Connor-Vickers/SASSII-PSP/PCB/untitled.BOT.bmp

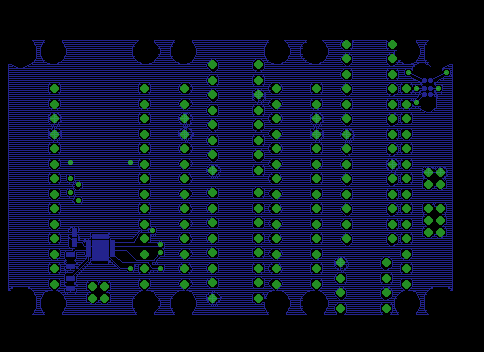
PCB/untitled.BOT.bmp
