Connor-Vickers/SASSII-PSP/PCB/untitled.DD1.bmp

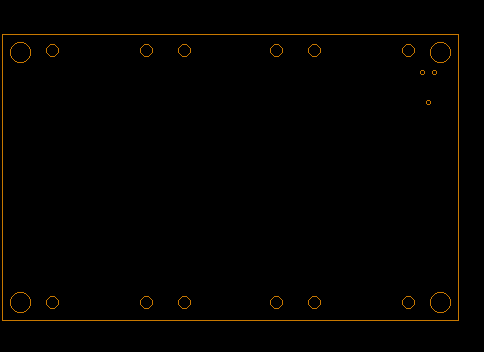
PCB/untitled.DD1.bmp
