Connor-Vickers/SASSII-PSP/PCB/untitled.GTO.bmp

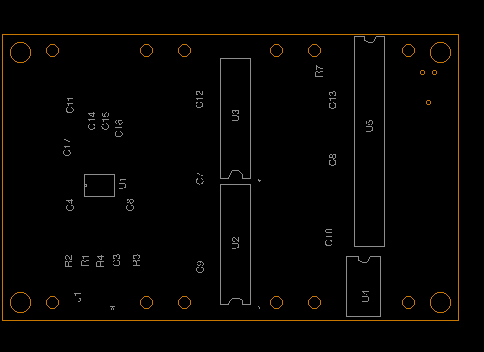
PCB/untitled.GTO.bmp
