Connor-Vickers/SASSII-PSP/PCB/untitled.L2.bmp

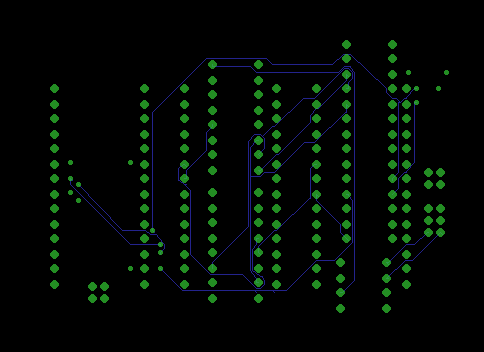
PCB/untitled.L2.bmp
