Connor-Vickers/SASSII-PSP/PCB/untitled.MSK.bmp

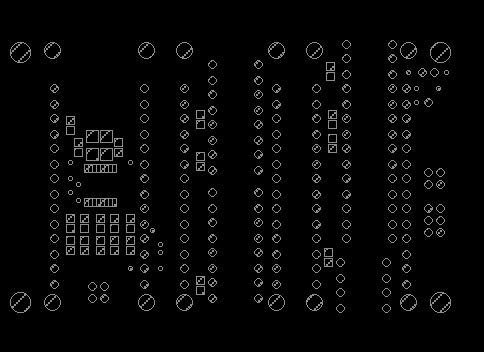
PCB/untitled.MSK.bmp
