Connor-Vickers/SASSII-PSP/PCB/untitled.STS.bmp

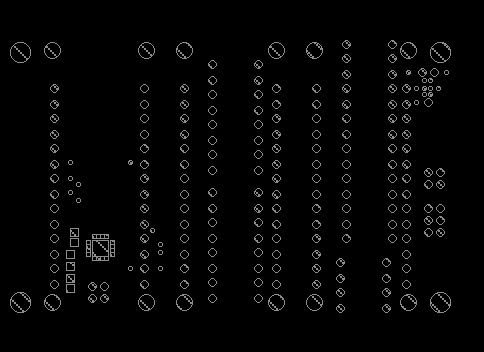
PCB/untitled.STS.bmp
