Connor-Vickers/SASSII-PSP/PCB/untitled.TAP.bmp

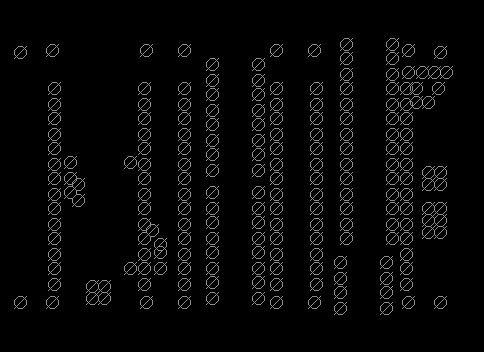
PCB/untitled.TAP.bmp
