Connor-Vickers/SASSII-PSP/PCB/untitled.TOP.bmp

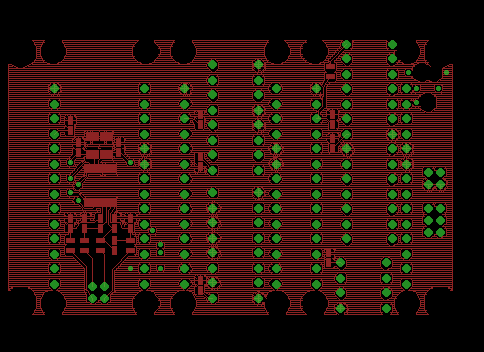
PCB/untitled.TOP.bmp
