Connor-Vickers/SASSII-PSP/PCB/untitled.brd

## EAGLE design PCB/untitled.brd (2017-12-06)

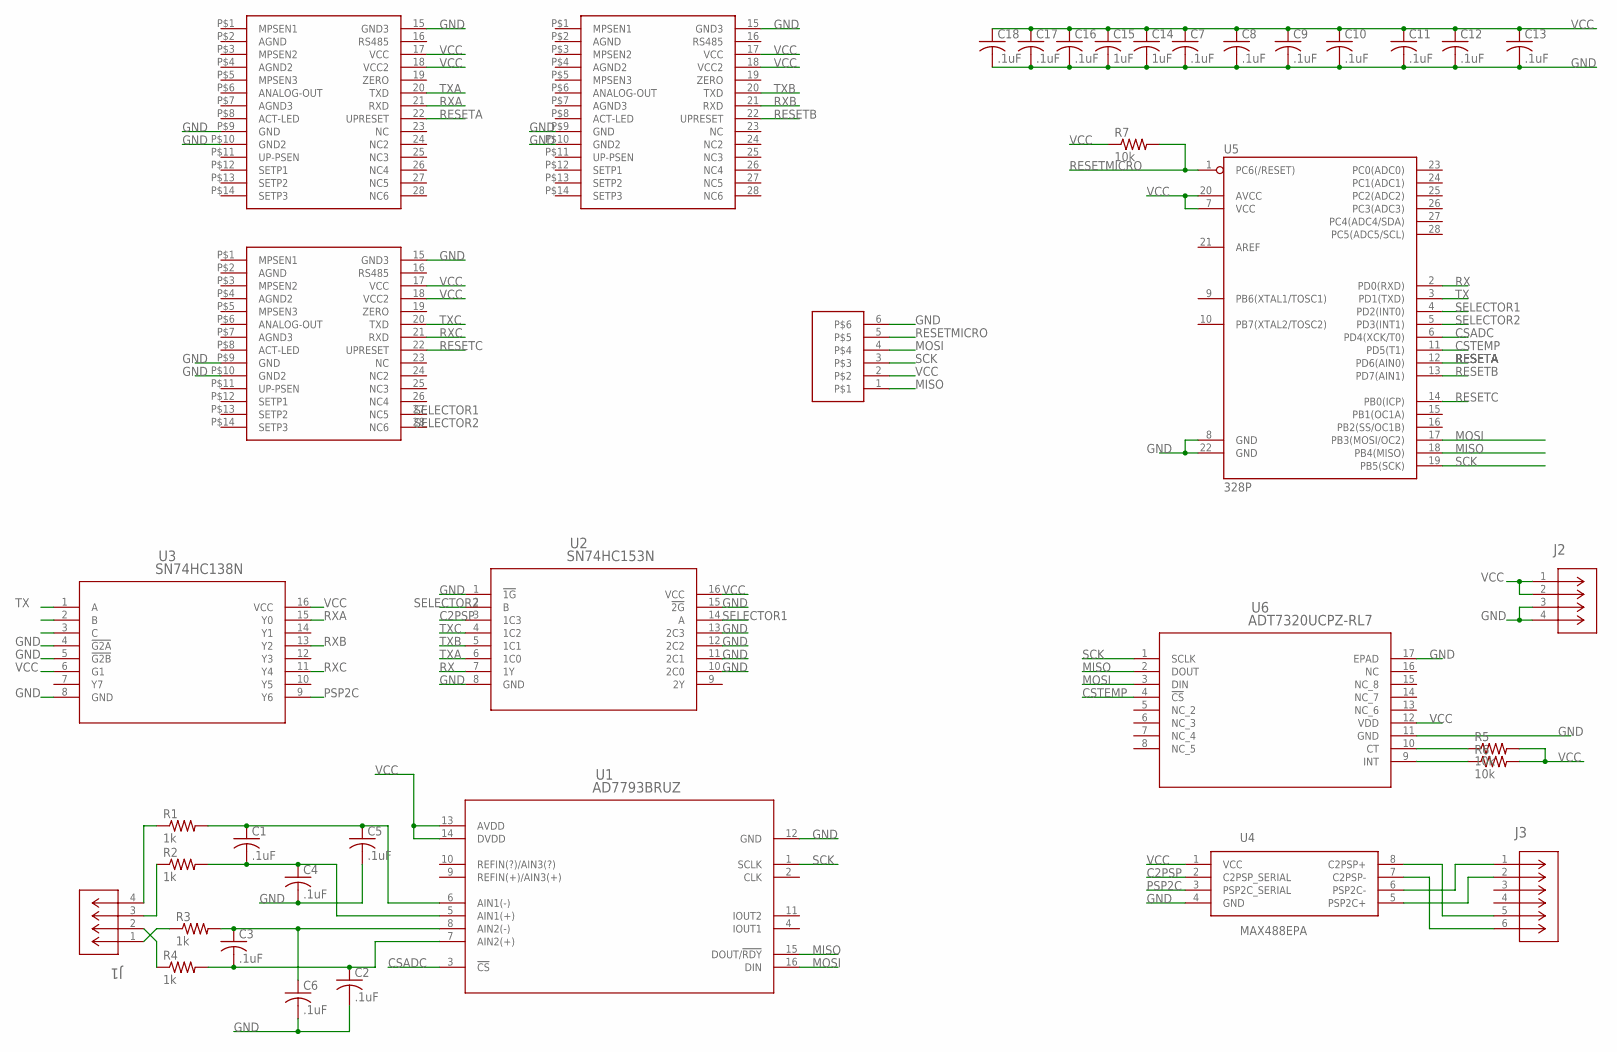
[picture p13: schematic untitled.sch]

Parts:
C1, C2, C3, C4, C5, C6, C7, C8, C9, C10, C11, C12, C13, C16, C17, C18: .1uF; C0603
C14, C15: 1uF; C1206
J1, J2: DF11-4
J3: DF11-6DP-2DSA(01); CON6_2X3_UF_DF11
R1, R2, R3, R4: 1k; R0603
R5, R6, R7: 10k; R0603
U1: AD7793BRUZ; RU_16
U2: SN74HC153N; N16
U3: SN74HC138N; N16
U4: MAX488EPA; DIL08
U5: 328P; DIP28
U6: ADT7320UCPZ-RL7; CP_16_17
U$1: PROGRAMMER
U$2, U$3, U$4: MKS-PIRANI; 28PIN

Connections:
C2PSP: U2.3 (1C3), U4.2 (C2PSP_SERIAL)
CSADC: U1.3 (!CS), U5.6 (PD4(XCK/T0))
CSTEMP: U5.11 (PD5(T1)), U6.4 (!CS)
GND: C2.2, C4.2, C5.2, C6.2, C7.2, C8.2, C9.2, C10.2, C11.2, C12.2, C13.2, C14.2, C15.2, C16.2, C17.2, C18.2, J2.3, J2.4, U1.12 (GND), U2.1 (!1G), U2.8 (GND), U2.10 (2C0), U2.11 (2C1), U2.12 (2C2), U2.13 (2C3), U2.15 (!2G), U3.4 (!G2A), U3.5 (!G2B), U3.8 (GND), U4.4 (GND), U5.8 (GND), U5.22 (GND), U6.11 (GND), U6.17 (EPAD), U$1.6, U$2.15 (GND3), U$2.P$9 (GND), U$2.P$10 (GND2), U$3.15 (GND3), U$3.P$9 (GND), U$3.P$10 (GND2), U$4.15 (GND3), U$4.P$9 (GND), U$4.P$10 (GND2)
MISO: U1.15 (DOUT/!RDY), U5.18 (PB4(MISO)), U6.2 (DOUT), U$1.1
MOSI: U1.16 (DIN), U5.17 (PB3(MOSI/OC2)), U6.3 (DIN), U$1.4
unnamed: J3.1, U4.6 (PSP2C-)
unnamed: J3.2, U4.5 (PSP2C+)
unnamed: J3.5, U4.8 (C2PSP+)
unnamed: J3.6, U4.7 (C2PSP-)
unnamed: C3.1, C6.1, R3.2, U1.8 (AIN2(-))
unnamed: J1.4, R1.1
unnamed: J1.3, R2.1
unnamed: J1.2, R4.1
unnamed: J1.1, R3.1
unnamed: C1.2, C4.1, R2.2, U1.5 (AIN1(+))
unnamed: C1.1, C5.1, R1.2, U1.6 (AIN1(-))
unnamed: C2.1, C3.2, R4.2, U1.7 (AIN2(+))
unnamed: R5.1, U6.10 (CT)
unnamed: R6.1, U6.9 (INT)
PSP2C: U3.9 (Y6), U4.3 (PSP2C_SERIAL)
RESETA: U5.12 (PD6(AIN0)), U$2.22 (UPRESET)
RESETB: U5.13 (PD7(AIN1)), U$4.22 (UPRESET)
RESETC: U5.14 (PB0(ICP)), U$3.22 (UPRESET)
RESETMICRO: R7.2, U5.1 (PC6(/RESET)), U$1.5
RX: U2.7 (1Y), U5.2 (PD0(RXD))
RXA: U3.15 (Y0), U$2.21 (RXD)
RXB: U3.13 (Y2), U$4.21 (RXD)
RXC: U3.11 (Y4), U$3.21 (RXD)
SCK: U1.1 (SCLK), U5.19 (PB5(SCK)), U6.1 (SCLK), U$1.3
SELECTOR1: U2.14 (A), U3.2 (B), U5.4 (PD2(INT0))
SELECTOR2: U2.2 (B), U3.3 (C), U5.5 (PD3(INT1))
TX: U3.1 (A), U5.3 (PD1(TXD))
TXA: U2.6 (1C0), U$2.20 (TXD)
TXB: U2.5 (1C1), U$4.20 (TXD)
TXC: U2.4 (1C2), U$3.20 (TXD)
VCC: C7.1, C8.1, C9.1, C10.1, C11.1, C12.1, C13.1, C14.1, C15.1, C16.1, C17.1, C18.1, J2.1, J2.2, R5.2, R6.2, R7.1, U1.13 (AVDD), U1.14 (DVDD), U2.16 (VCC), U3.6 (G1), U3.16 (VCC), U4.1 (VCC), U5.7 (VCC), U5.20 (AVCC), U6.12 (VDD), U$1.2, U$2.17 (VCC), U$2.18 (VCC2), U$3.17 (VCC), U$3.18 (VCC2), U$4.17 (VCC), U$4.18 (VCC2)

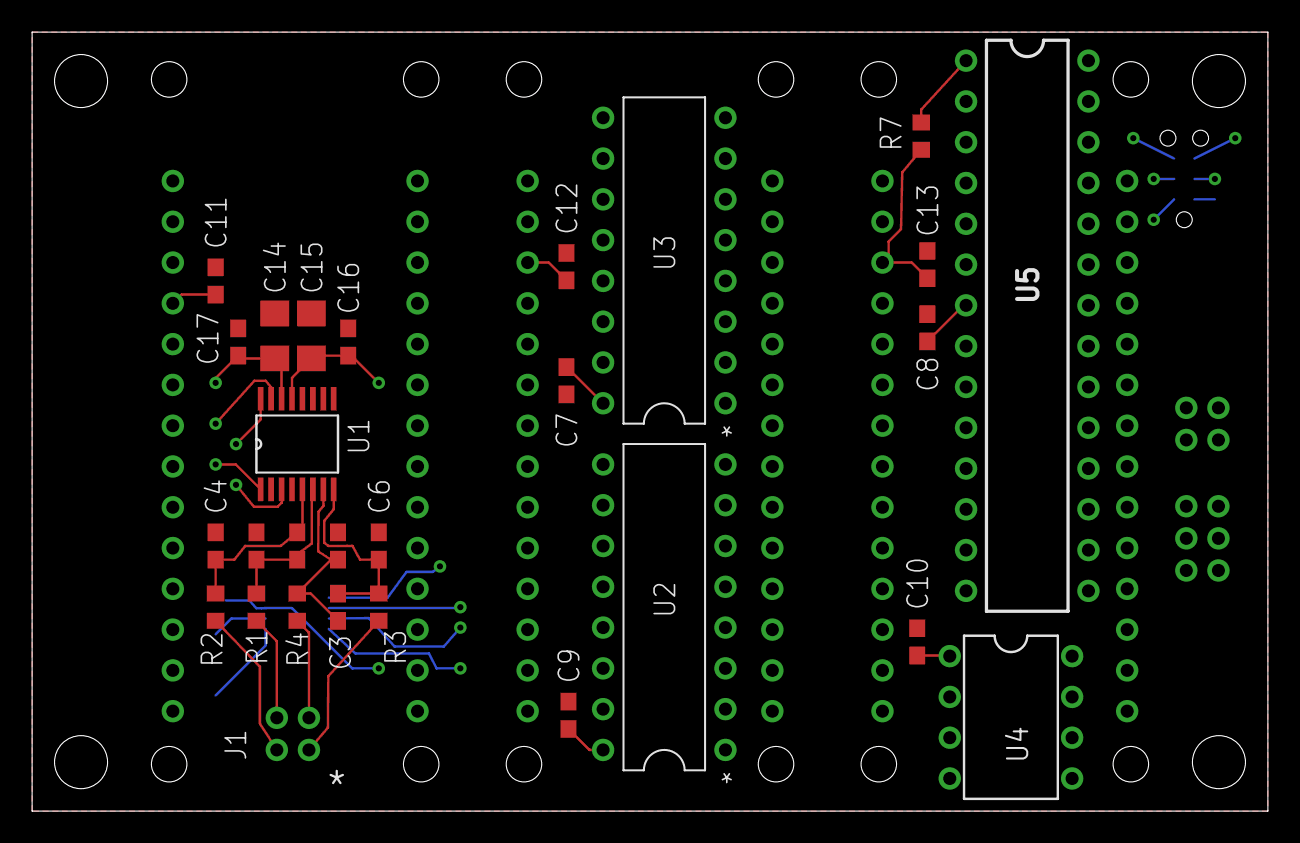
[picture p14: board untitled.brd from above]

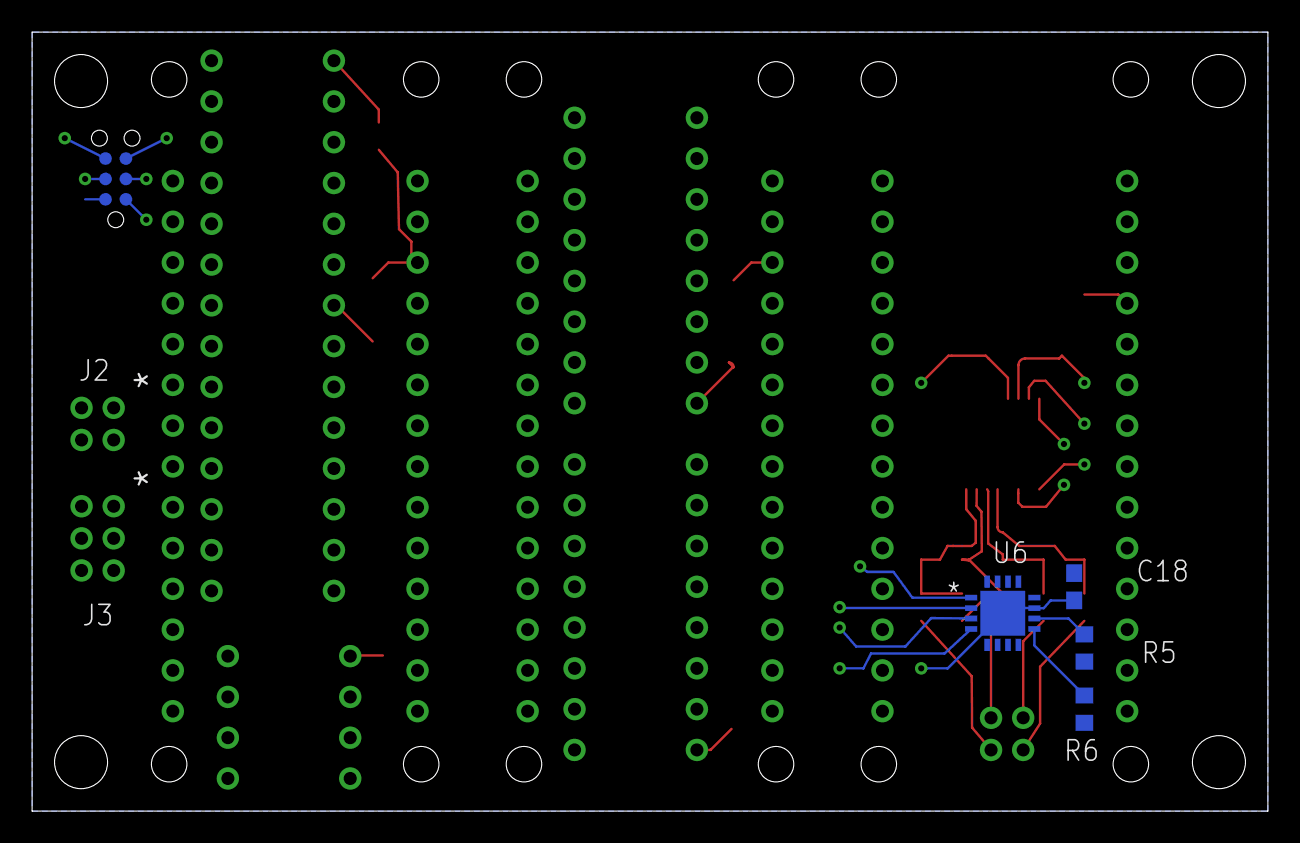
[picture p15: board untitled.brd from below]

Board: 4 copper layers, 77.0 x 48.5 mm, 38 parts (7 on the bottom side), 37 nets.
